HaydenKeers/meower_kicad/_restore_backup_2026-08-23T15-10-23-191/import2.kicad_pcb

## KiCad design _restore_backup_2026-08-23T15-10-23-191/import2.kicad_pcb (2026-08-23)

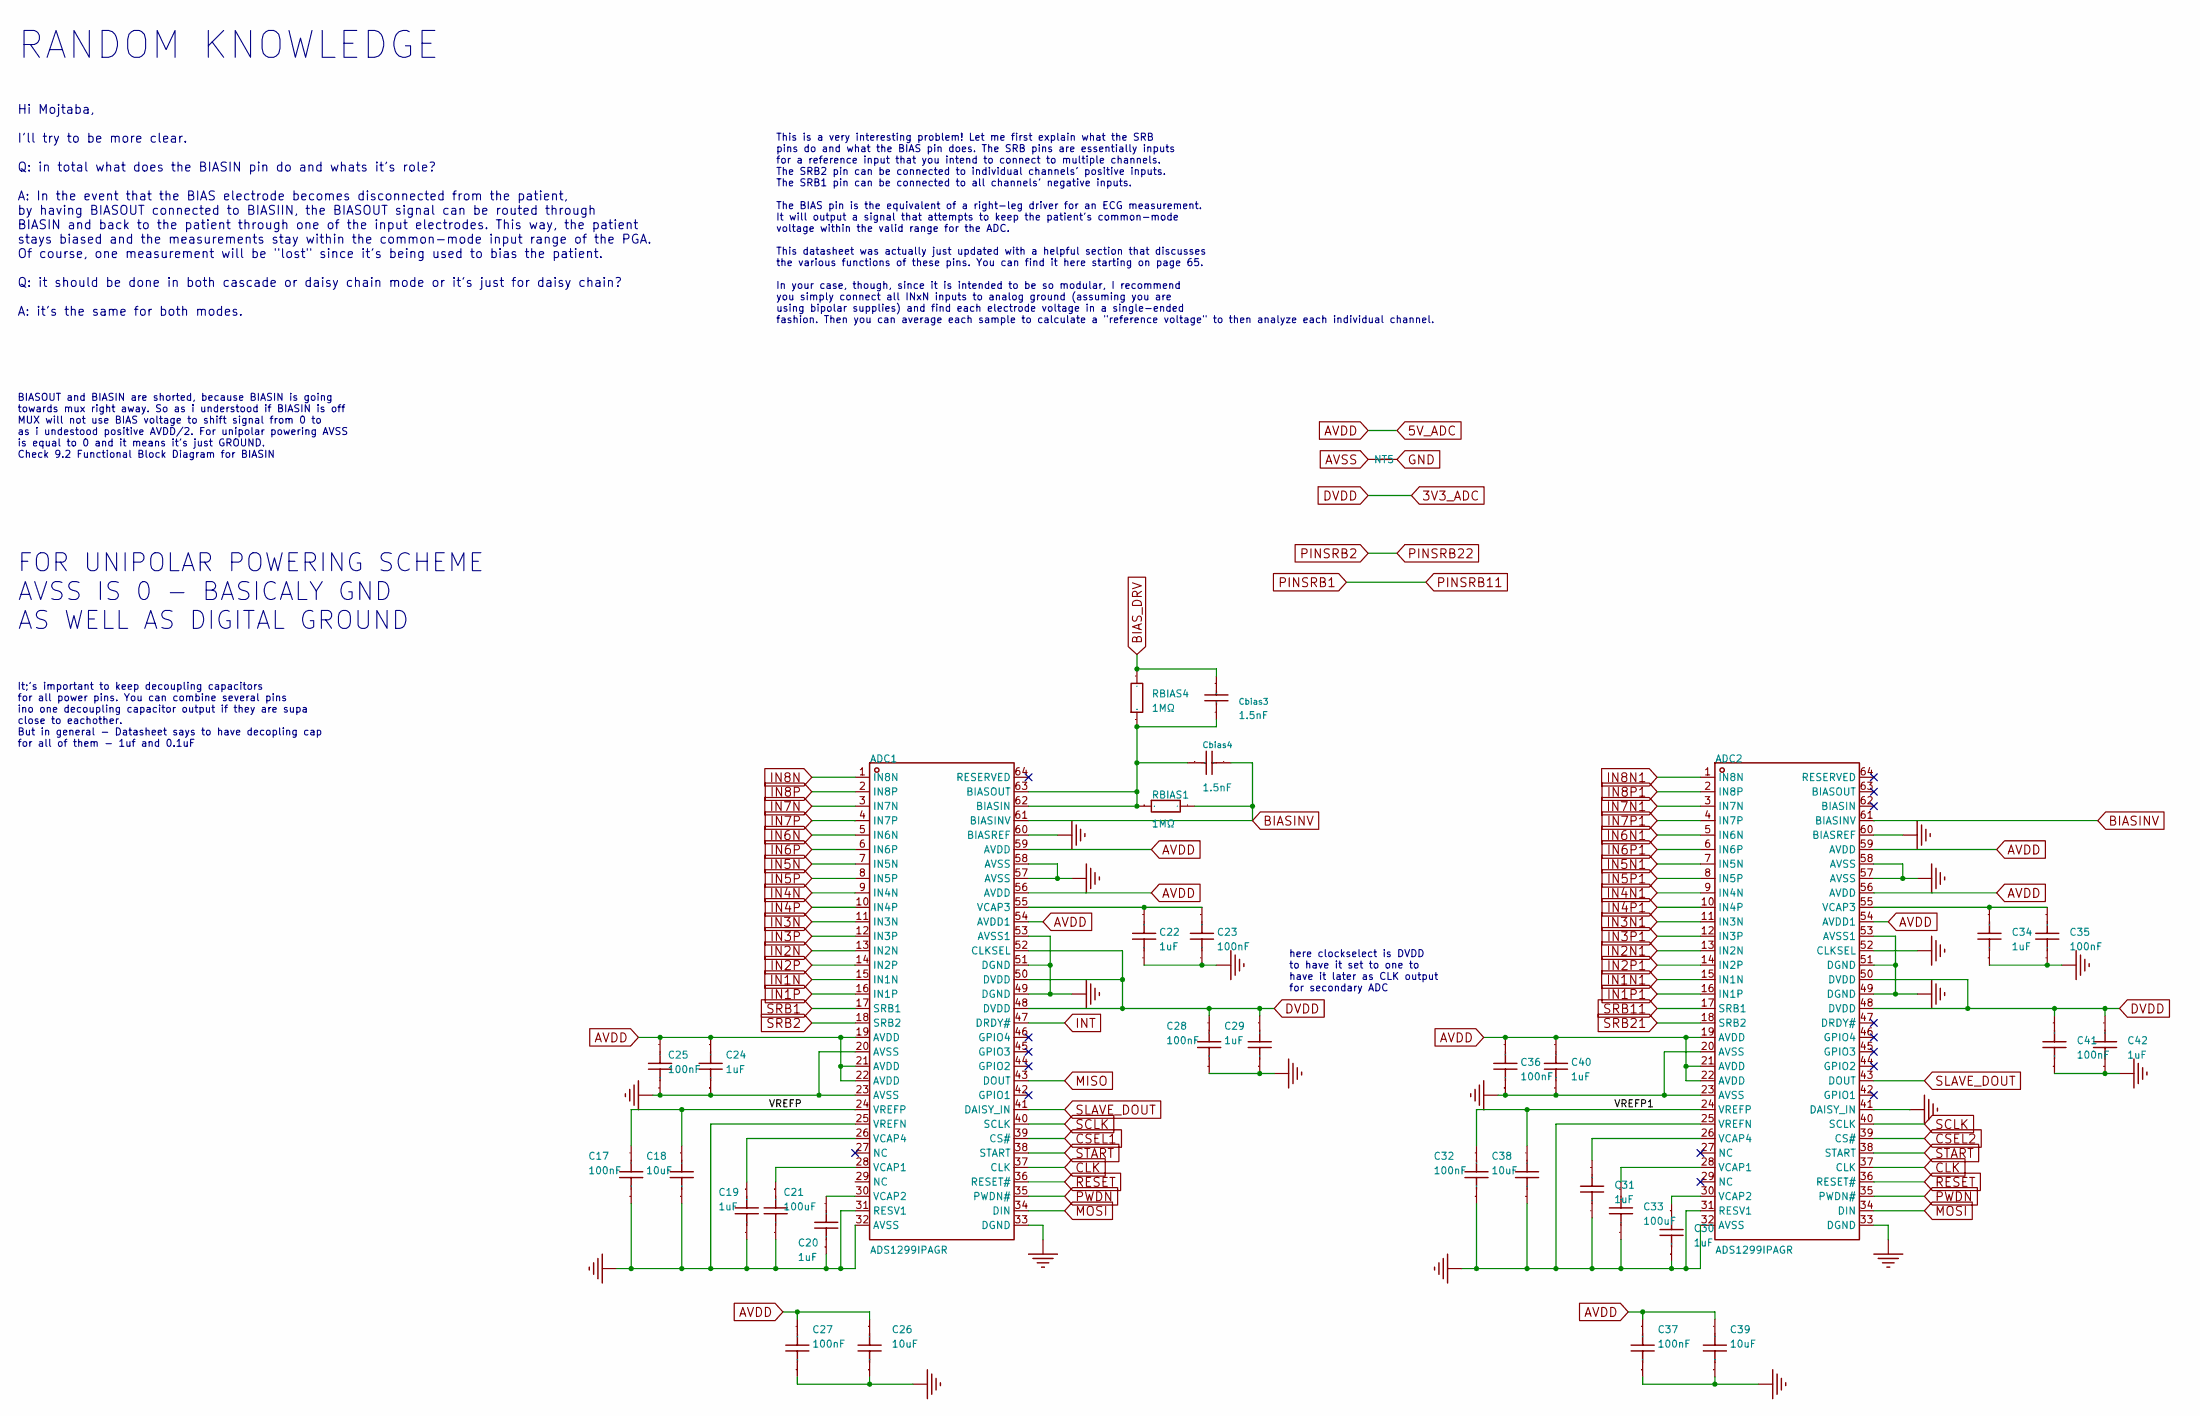
[picture p1: schematic 2_ADCs.kicad_sch]

Parts:
ADC1, ADC2: ADS1299IPAGR; TQFP-64_L10.0-W10.0-P0.50-LS12.0-TL; Voltage - Supply 4.75V~5.25V; Voltage Reference Drift 35ppm/℃; Manufacturer Part ADS1299IPAGR; LCSC Part Name ADS1299-x 低噪声、4/6/8通道、24bit 、同时采样模数转换器，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
C17, C23, C25, C27, C28, C32, C35, C36, C37, C41: 100nF; C0603; Manufacturer Part GRM188R71H104KA93D; LCSC Part Name 100nF ±10% 50V
C18, C26, C38, C39: 10uF; C0805; Manufacturer Part GRM188R61A106KE69D; LCSC Part Name 10uF ±10% 10V
C19, C20, C22, C30, C31, C34: 1uF; C0603; Manufacturer Part GRM188R61E105KA12D; LCSC Part Name 1uF ±10% 25V
C21, C33: 100uF; C1210; Manufacturer Part LMK325BJ107MM-T; LCSC Part Name 100uF ±20% 10V
C24, C29, C40, C42: 1uF; C0805; Manufacturer Part GRM188R61E105KA12D; LCSC Part Name 1uF ±10% 25V
Cbias3, Cbias4: 1.5nF; C0402; Voltage Rating 50V; Manufacturer Part GCM155R71H152KA37D; LCSC Part Name 1.5nF ±10% 50V
NT5: NetTie_2; NetTie-2_SMD_Pad0.5mm
RBIAS1, RBIAS4: 1MΩ; R0603; Manufacturer Part RC0402FR-071ML; LCSC Part Name 厚膜电阻 1MΩ ±1% 62.5mW

Connections:
3V3_ADC: ADC1.48 (DVDD), ADC1.50 (DVDD), ADC1.52 (CLKSEL), ADC2.48 (DVDD), ADC2.50 (DVDD), C28.2, C29.2, C41.2, C42.2; also elsewhere on the board
5V_ADC: ADC1.19 (AVDD), ADC1.21 (AVDD), ADC1.22 (AVDD), ADC1.54 (AVDD1), ADC1.56 (AVDD), ADC1.59 (AVDD), ADC2.19 (AVDD), ADC2.21 (AVDD), ADC2.22 (AVDD), ADC2.54 (AVDD1), ADC2.56 (AVDD), ADC2.59 (AVDD), C24.2, C25.2, C26.2, C27.2, C36.2, C37.2, C39.2, C40.2; also elsewhere on the board
/ADCs/VREFP: ADC1.24 (VREFP), C17.2, C18.2
/ADCs/VREFP1: ADC2.24 (VREFP), C32.2, C38.2
AVSS: ADC1.20 (AVSS), ADC1.23 (AVSS), ADC1.25 (VREFN), ADC1.31 (RESV1), ADC1.32 (AVSS), ADC1.57 (AVSS), ADC1.58 (AVSS), ADC1.60 (BIASREF), ADC2.20 (AVSS), ADC2.23 (AVSS), ADC2.25 (VREFN), ADC2.31 (RESV1), ADC2.32 (AVSS), ADC2.57 (AVSS), ADC2.58 (AVSS), ADC2.60 (BIASREF), C17.1, C18.1, C19.2, C20.1, C21.2, C24.1, C25.1, C30.1, C31.2, C32.1, C33.2, C36.1, C38.1, C40.1, NT5.1; also elsewhere on the board
BIASINV: ADC1.61 (BIASINV), ADC2.61 (BIASINV), Cbias4.2, RBIAS1.2
BIAS_DRV: Cbias3.1, RBIAS4.2; also elsewhere on the board
CLK: ADC1.37 (CLK), ADC2.37 (CLK)
CSEL1: ADC1.39 (CS#); also elsewhere on the board
CSEL2: ADC2.39 (CS#); also elsewhere on the board
GND: ADC1.33 (DGND), ADC1.49 (DGND), ADC1.51 (DGND), ADC1.53 (AVSS1), ADC2.33 (DGND), ADC2.41 (DAISY_IN), ADC2.49 (DGND), ADC2.51 (DGND), ADC2.52 (CLKSEL), ADC2.53 (AVSS1), C22.2, C23.2, C26.1, C27.1, C28.1, C29.1, C34.2, C35.2, C37.1, C39.1, C41.1, C42.1, NT5.2; also elsewhere on the board
IN1N: ADC1.15 (IN1N); also elsewhere on the board
IN1N1: ADC2.15 (IN1N); also elsewhere on the board
IN1P: ADC1.16 (IN1P); also elsewhere on the board
IN1P1: ADC2.16 (IN1P); also elsewhere on the board
IN2N: ADC1.13 (IN2N); also elsewhere on the board
IN2N1: ADC2.13 (IN2N); also elsewhere on the board
IN2P: ADC1.14 (IN2P); also elsewhere on the board
IN2P1: ADC2.14 (IN2P); also elsewhere on the board
IN3N: ADC1.11 (IN3N); also elsewhere on the board
IN3N1: ADC2.11 (IN3N); also elsewhere on the board
IN3P: ADC1.12 (IN3P); also elsewhere on the board
IN3P1: ADC2.12 (IN3P); also elsewhere on the board
IN4N: ADC1.9 (IN4N); also elsewhere on the board
IN4N1: ADC2.9 (IN4N); also elsewhere on the board
IN4P: ADC1.10 (IN4P); also elsewhere on the board
IN4P1: ADC2.10 (IN4P); also elsewhere on the board
IN5N: ADC1.7 (IN5N); also elsewhere on the board
IN5N1: ADC2.7 (IN5N); also elsewhere on the board
IN5P: ADC1.8 (IN5P); also elsewhere on the board
IN5P1: ADC2.8 (IN5P); also elsewhere on the board
IN6N: ADC1.5 (IN6N); also elsewhere on the board
IN6N1: ADC2.5 (IN6N); also elsewhere on the board
IN6P: ADC1.6 (IN6P); also elsewhere on the board
IN6P1: ADC2.6 (IN6P); also elsewhere on the board
IN7N: ADC1.3 (IN7N); also elsewhere on the board
IN7N1: ADC2.3 (IN7N); also elsewhere on the board
IN7P: ADC1.4 (IN7P); also elsewhere on the board
IN7P1: ADC2.4 (IN7P); also elsewhere on the board
IN8N: ADC1.1 (IN8N); also elsewhere on the board
IN8N1: ADC2.1 (IN8N); also elsewhere on the board
IN8P: ADC1.2 (IN8P); also elsewhere on the board
IN8P1: ADC2.2 (IN8P); also elsewhere on the board
INT: ADC1.47 (DRDY#); also elsewhere on the board
MISO: ADC1.43 (DOUT); also elsewhere on the board
MOSI: ADC1.34 (DIN), ADC2.34 (DIN); also elsewhere on the board
unnamed: ADC1.62 (BIASIN), ADC1.63 (BIASOUT), Cbias3.2, Cbias4.1, RBIAS1.1, RBIAS4.1
unnamed: ADC1.28 (VCAP1), C21.1
unnamed: ADC1.30 (VCAP2), C20.2
unnamed: ADC1.55 (VCAP3), C22.1, C23.1
unnamed: ADC1.26 (VCAP4), C19.1
unnamed: ADC2.28 (VCAP1), C33.1
unnamed: ADC2.30 (VCAP2), C30.2
unnamed: ADC2.55 (VCAP3), C34.1, C35.1
unnamed: ADC2.26 (VCAP4), C31.1
PWDN: ADC1.35 (PWDN#), ADC2.35 (PWDN#); also elsewhere on the board
RESET: ADC1.36 (RESET#), ADC2.36 (RESET#); also elsewhere on the board
SCLK: ADC1.40 (SCLK), ADC2.40 (SCLK); also elsewhere on the board
SLAVE_DOUT: ADC1.41 (DAISY_IN), ADC2.43 (DOUT)
SRB1: ADC1.17 (SRB1); also elsewhere on the board
SRB2: ADC1.18 (SRB2); also elsewhere on the board
SRB11: ADC2.17 (SRB1); also elsewhere on the board
SRB21: ADC2.18 (SRB2); also elsewhere on the board
START: ADC1.38 (START), ADC2.38 (START); also elsewhere on the board

Notes on the sheet:
It;'s important to keep decoupling capacitors for all power pins. You can combine several pins ino one decoupling capacitor output if they are supa close to eachother. But in general - Datasheet says to have decopling cap for all of them - 1uf and 0.1uF
FOR UNIPOLAR POWERING SCHEME AVSS IS 0 - BASICALY GND AS WELL AS DIGITAL GROUND
Hi Mojtaba, I'll try to be more clear. Q: in total what does the BIASIN pin do and whats it's role? A: In the event that the BIAS electrode becomes disconnected from the patient, by having BIASOUT connected to BIASIIN, the BIASOUT signal can be routed through BIASIN and back to the patient through 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
BIASOUT and BIASIN are shorted, because BIASIN is going towards mux right away. So as i understood if BIASIN is off MUX will not use BIAS voltage to shift signal from 0 to as i undestood positive AVDD/2. For unipolar powering AVSS is equal to 0 and it means it's just GROUND. Check 9.2 Functional Bl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
here clockselect is DVDD to have it set to one to have it later as CLK output for secondary ADC
This is a very interesting problem! Let me first explain what the SRB pins do and what the BIAS pin does. The SRB pins are essentially inputs for a reference input that you intend to connect to multiple channels. The SRB2 pin can be connected to individual channels' positive inputs. The SRB1 pin ca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
RANDOM KNOWLEDGE

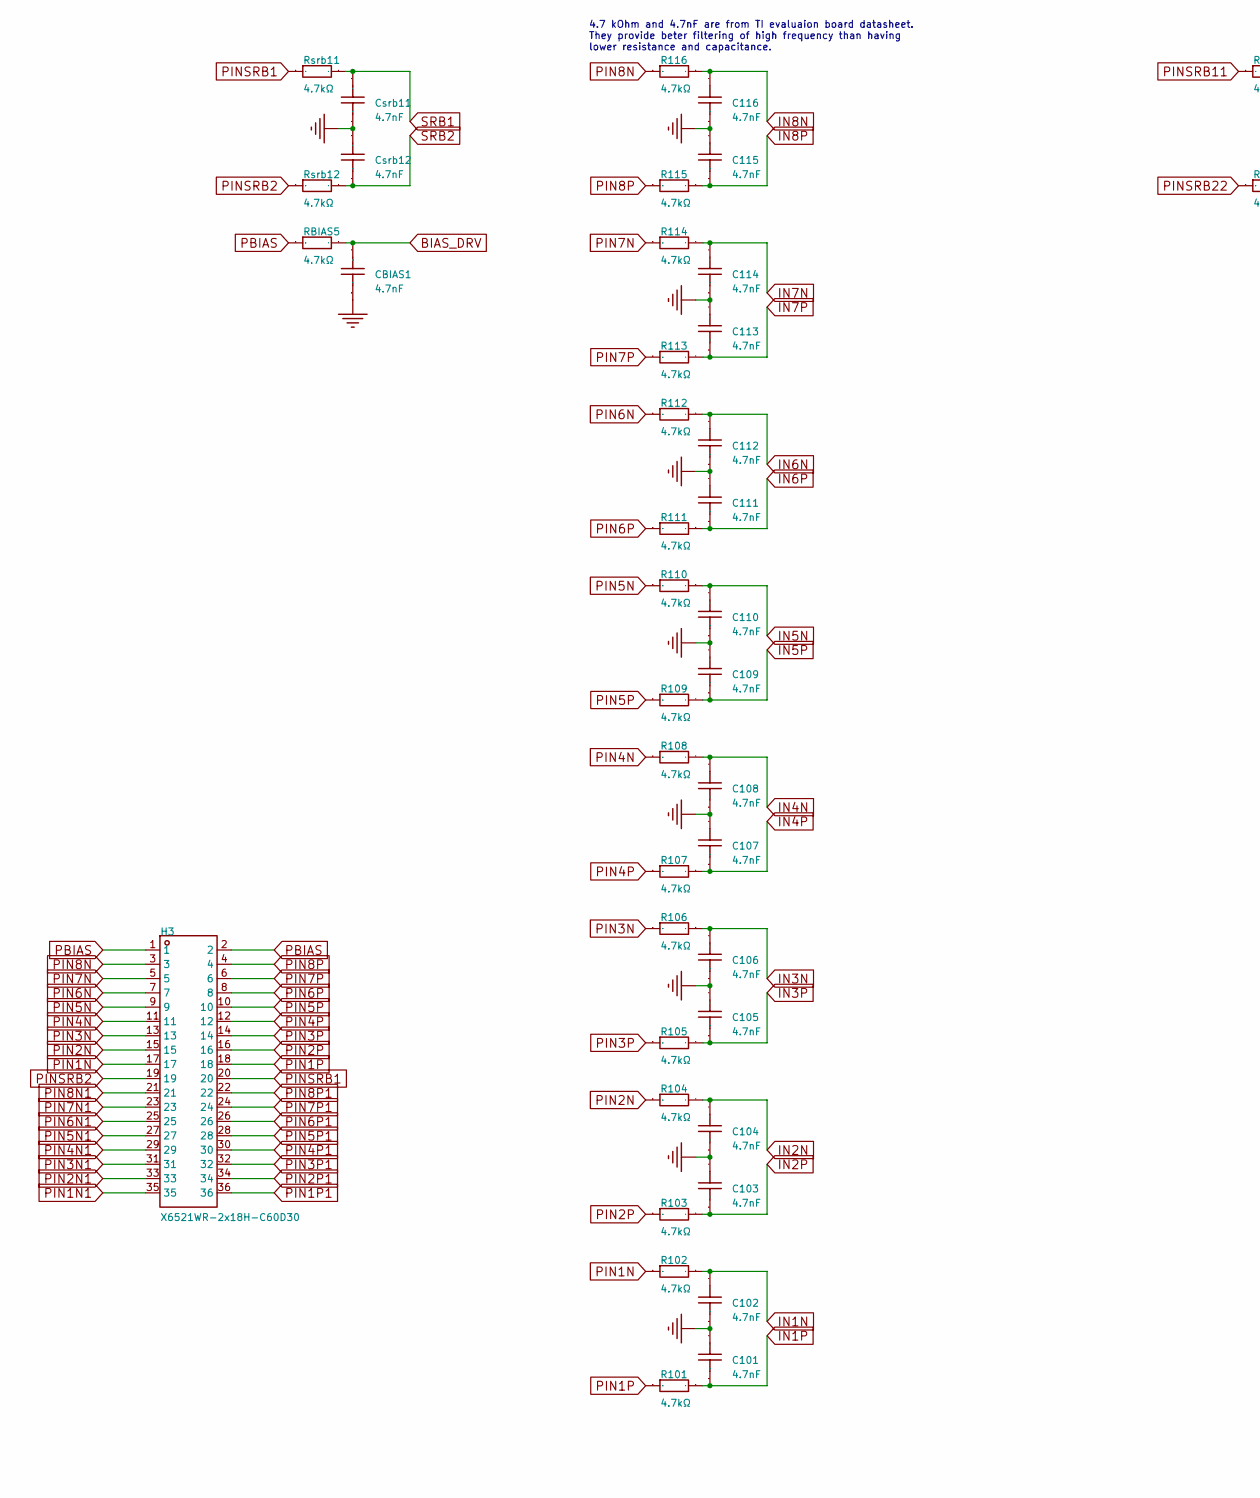
[picture p2: schematic 3_ADC pins and connector.kicad_sch, part in row 1, column 1]

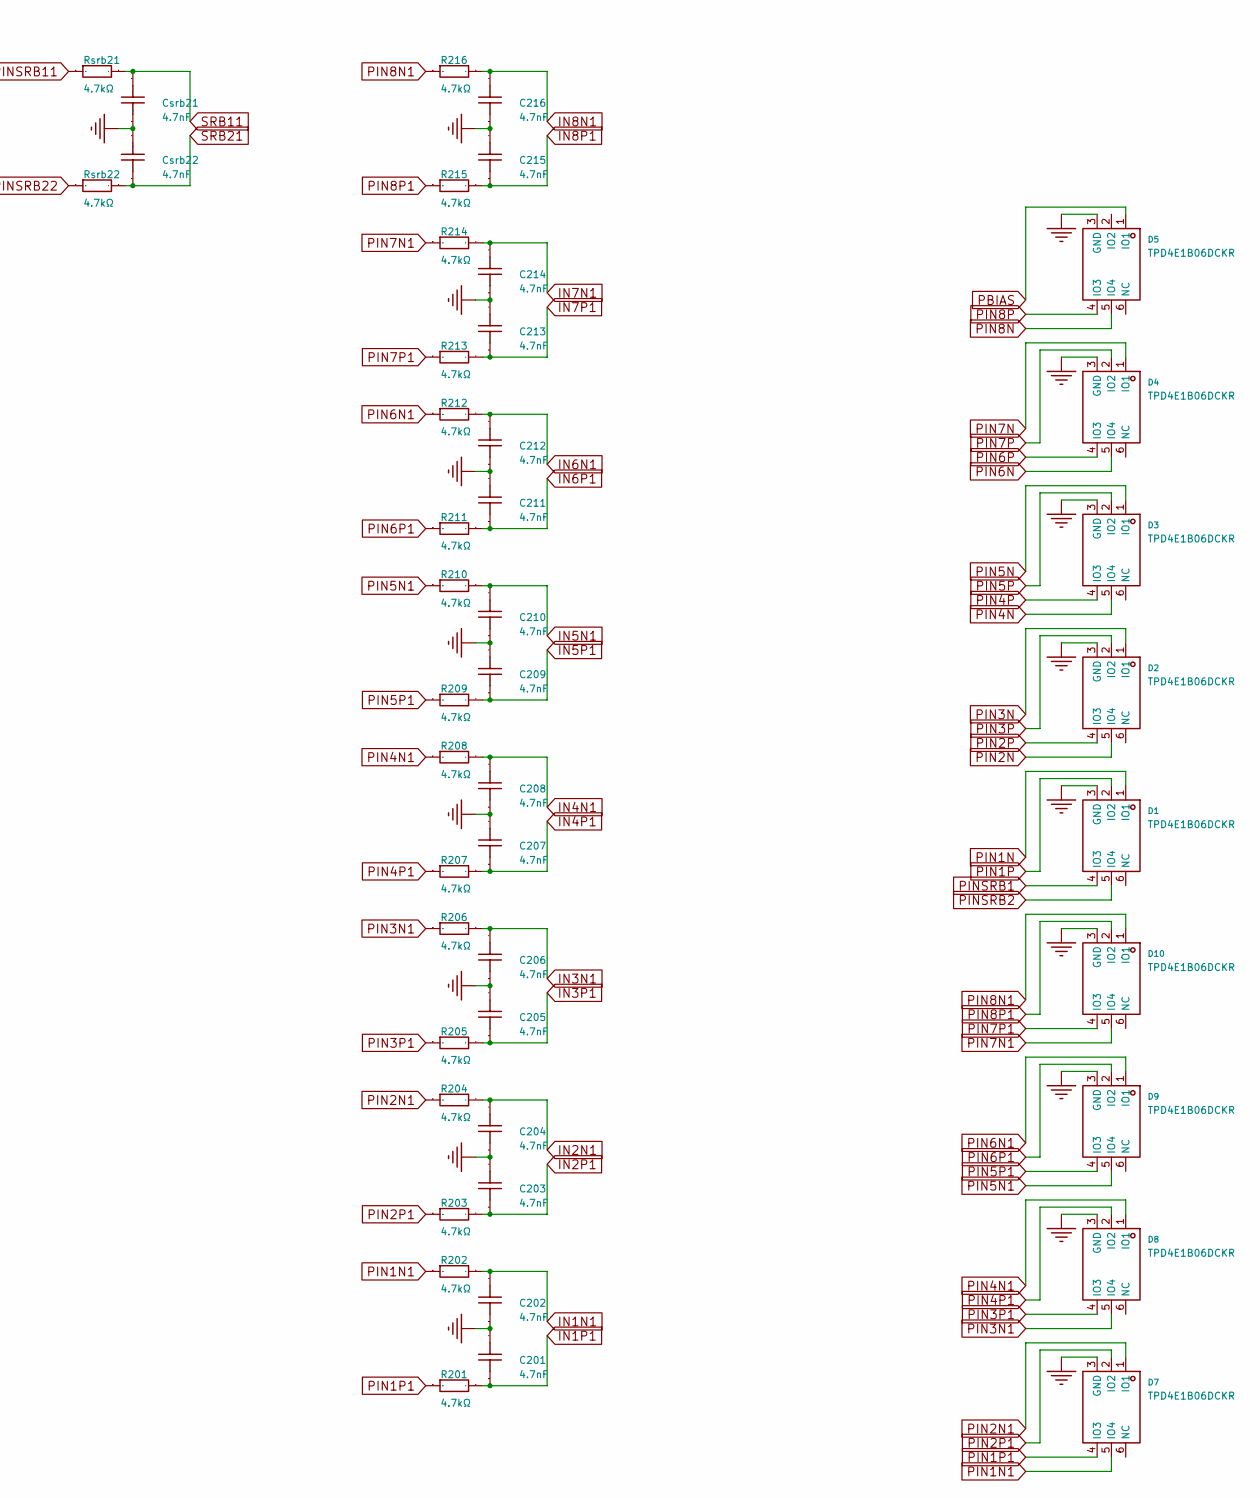
[picture p3: schematic 3_ADC pins and connector.kicad_sch, part in row 1, column 2]

Parts:
C101, C102, C103, C104, C105, C106, C107, C108, C109, C110, C111, C112, C113, C114, C115, C116, C201, C202, C203, C204, C205, C206, C207, C208, C209, C210, C211, C212, C213, C214, C215, C216: 4.7nF; C0402; Tolerance ±2%; Voltage Rating 50V; Manufacturer Part GRM1555C1H472GE01D; LCSC Part Name 4.7nF ±2% 50V
CBIAS1: 4.7nF; C0402; Tolerance ±2%; Voltage Rating 50V; Manufacturer Part GRM1555C1H472GE01D; LCSC Part Name 4.7nF ±2% 50V
Csrb11, Csrb12, Csrb21, Csrb22: 4.7nF; C0402; Tolerance ±2%; Voltage Rating 50V; Manufacturer Part GRM1555C1H472GE01D; LCSC Part Name 4.7nF ±2% 50V
D1, D2, D3, D4, D5, D7, D8, D9, D10: TPD4E1B06DCKR; SC-70-6_L2.2-W1.3-P0.65-LS2.1-BL; Manufacturer Part TPD4E1B06DCKR; LCSC Part Name TPD4E1B06DCKR
H3: X6521WR-2x18H-C60D30; HDR-TH_36P-P2.54-H-M-R2-C18-S2.54; Manufacturer Part X6521WR-2x18H-C60D30; LCSC Part Name 2x18P 间距:2.54mm 方针
R101, R102, R103, R104, R105, R106, R107, R108, R109, R110, R111, R112, R113, R114, R115, R116, R201, R202, R203, R204, R205, R206, R207, R208, R209, R210, R211, R212, R213, R214, R215, R216: 4.7kΩ; R0402; Manufacturer Part RC0402FR-074K7L; LCSC Part Name 厚膜电阻 4.7kΩ ±1% 62.5mW
RBIAS5: 4.7kΩ; R0402; Manufacturer Part RC0402FR-074K7L; LCSC Part Name 厚膜电阻 4.7kΩ ±1% 62.5mW
Rsrb11, Rsrb12, Rsrb21, Rsrb22: 4.7kΩ; R0402; Manufacturer Part RC0402FR-074K7L; LCSC Part Name 厚膜电阻 4.7kΩ ±1% 62.5mW

Connections:
AVSS: C101.2, C102.1, C103.2, C104.1, C105.2, C106.1, C107.2, C108.1, C109.2, C110.1, C111.2, C112.1, C113.2, C114.1, C115.2, C116.1, C201.2, C202.1, C203.2, C204.1, C205.2, C206.1, C207.2, C208.1, C209.2, C210.1, C211.2, C212.1, C213.2, C214.1, C215.2, C216.1, CBIAS1.1, Csrb11.1, Csrb12.2, Csrb21.1, Csrb22.2, D1.3 (GND), D2.3 (GND), D3.3 (GND), D4.3 (GND), D5.3 (GND), D7.3 (GND), D8.3 (GND), D9.3 (GND), D10.3 (GND); also elsewhere on the board
BIAS_DRV: CBIAS1.2, RBIAS5.2; also elsewhere on the board
IN1N: C102.2, R102.2; also elsewhere on the board
IN1N1: C202.2, R202.2; also elsewhere on the board
IN1P: C101.1, R101.2; also elsewhere on the board
IN1P1: C201.1, R201.2; also elsewhere on the board
IN2N: C104.2, R104.2; also elsewhere on the board
IN2N1: C204.2, R204.2; also elsewhere on the board
IN2P: C103.1, R103.2; also elsewhere on the board
IN2P1: C203.1, R203.2; also elsewhere on the board
IN3N: C106.2, R106.2; also elsewhere on the board
IN3N1: C206.2, R206.2; also elsewhere on the board
IN3P: C105.1, R105.2; also elsewhere on the board
IN3P1: C205.1, R205.2; also elsewhere on the board
IN4N: C108.2, R108.2; also elsewhere on the board
IN4N1: C208.2, R208.2; also elsewhere on the board
IN4P: C107.1, R107.2; also elsewhere on the board
IN4P1: C207.1, R207.2; also elsewhere on the board
IN5N: C110.2, R110.2; also elsewhere on the board
IN5N1: C210.2, R210.2; also elsewhere on the board
IN5P: C109.1, R109.2; also elsewhere on the board
IN5P1: C209.1, R209.2; also elsewhere on the board
IN6N: C112.2, R112.2; also elsewhere on the board
IN6N1: C212.2, R212.2; also elsewhere on the board
IN6P: C111.1, R111.2; also elsewhere on the board
IN6P1: C211.1, R211.2; also elsewhere on the board
IN7N: C114.2, R114.2; also elsewhere on the board
IN7N1: C214.2, R214.2; also elsewhere on the board
IN7P: C113.1, R113.2; also elsewhere on the board
IN7P1: C213.1, R213.2; also elsewhere on the board
IN8N: C116.2, R116.2; also elsewhere on the board
IN8N1: C216.2, R216.2; also elsewhere on the board
IN8P: C115.1, R115.2; also elsewhere on the board
IN8P1: C215.1, R215.2; also elsewhere on the board
PBIAS: D5.1 (IO1), H3.1, H3.2, RBIAS5.1
PIN1N: D1.1 (IO1), H3.17, R102.1
PIN1N1: D7.5 (IO4), H3.35, R202.1
PIN1P: D1.2 (IO2), H3.18, R101.1
PIN1P1: D7.4 (IO3), H3.36, R201.1
PIN2N: D2.5 (IO4), H3.15, R104.1
PIN2N1: D7.1 (IO1), H3.33, R204.1
PIN2P: D2.4 (IO3), H3.16, R103.1
PIN2P1: D7.2 (IO2), H3.34, R203.1
PIN3N: D2.1 (IO1), H3.13, R106.1
PIN3N1: D8.5 (IO4), H3.31, R206.1
PIN3P: D2.2 (IO2), H3.14, R105.1
PIN3P1: D8.4 (IO3), H3.32, R205.1
PIN4N: D3.5 (IO4), H3.11, R108.1
PIN4N1: D8.1 (IO1), H3.29, R208.1
PIN4P: D3.4 (IO3), H3.12, R107.1
PIN4P1: D8.2 (IO2), H3.30, R207.1
PIN5N: D3.1 (IO1), H3.9, R110.1
PIN5N1: D9.5 (IO4), H3.27, R210.1
PIN5P: D3.2 (IO2), H3.10, R109.1
PIN5P1: D9.4 (IO3), H3.28, R209.1
PIN6N: D4.5 (IO4), H3.7, R112.1
PIN6N1: D9.1 (IO1), H3.25, R212.1
PIN6P: D4.4 (IO3), H3.8, R111.1
PIN6P1: D9.2 (IO2), H3.26, R211.1
PIN7N: D4.1 (IO1), H3.5, R114.1
PIN7N1: D10.5 (IO4), H3.23, R214.1
PIN7P: D4.2 (IO2), H3.6, R113.1
PIN7P1: D10.4 (IO3), H3.24, R213.1
PIN8N: D5.5 (IO4), H3.3, R116.1
PIN8N1: D10.1 (IO1), H3.21, R216.1
PIN8P: D5.4 (IO3), H3.4, R115.1
PIN8P1: D10.2 (IO2), H3.22, R215.1
SRB1: Csrb11.2, Rsrb11.2; also elsewhere on the board
SRB2: Csrb12.1, Rsrb12.2; also elsewhere on the board
SRB11: Csrb21.2, Rsrb21.2; also elsewhere on the board
SRB21: Csrb22.1, Rsrb22.2; also elsewhere on the board

Notes on the sheet:
4.7 kOhm and 4.7nF are from TI evaluaion board datasheet. They provide beter filtering of high frequency than having lower resistance and capacitance.

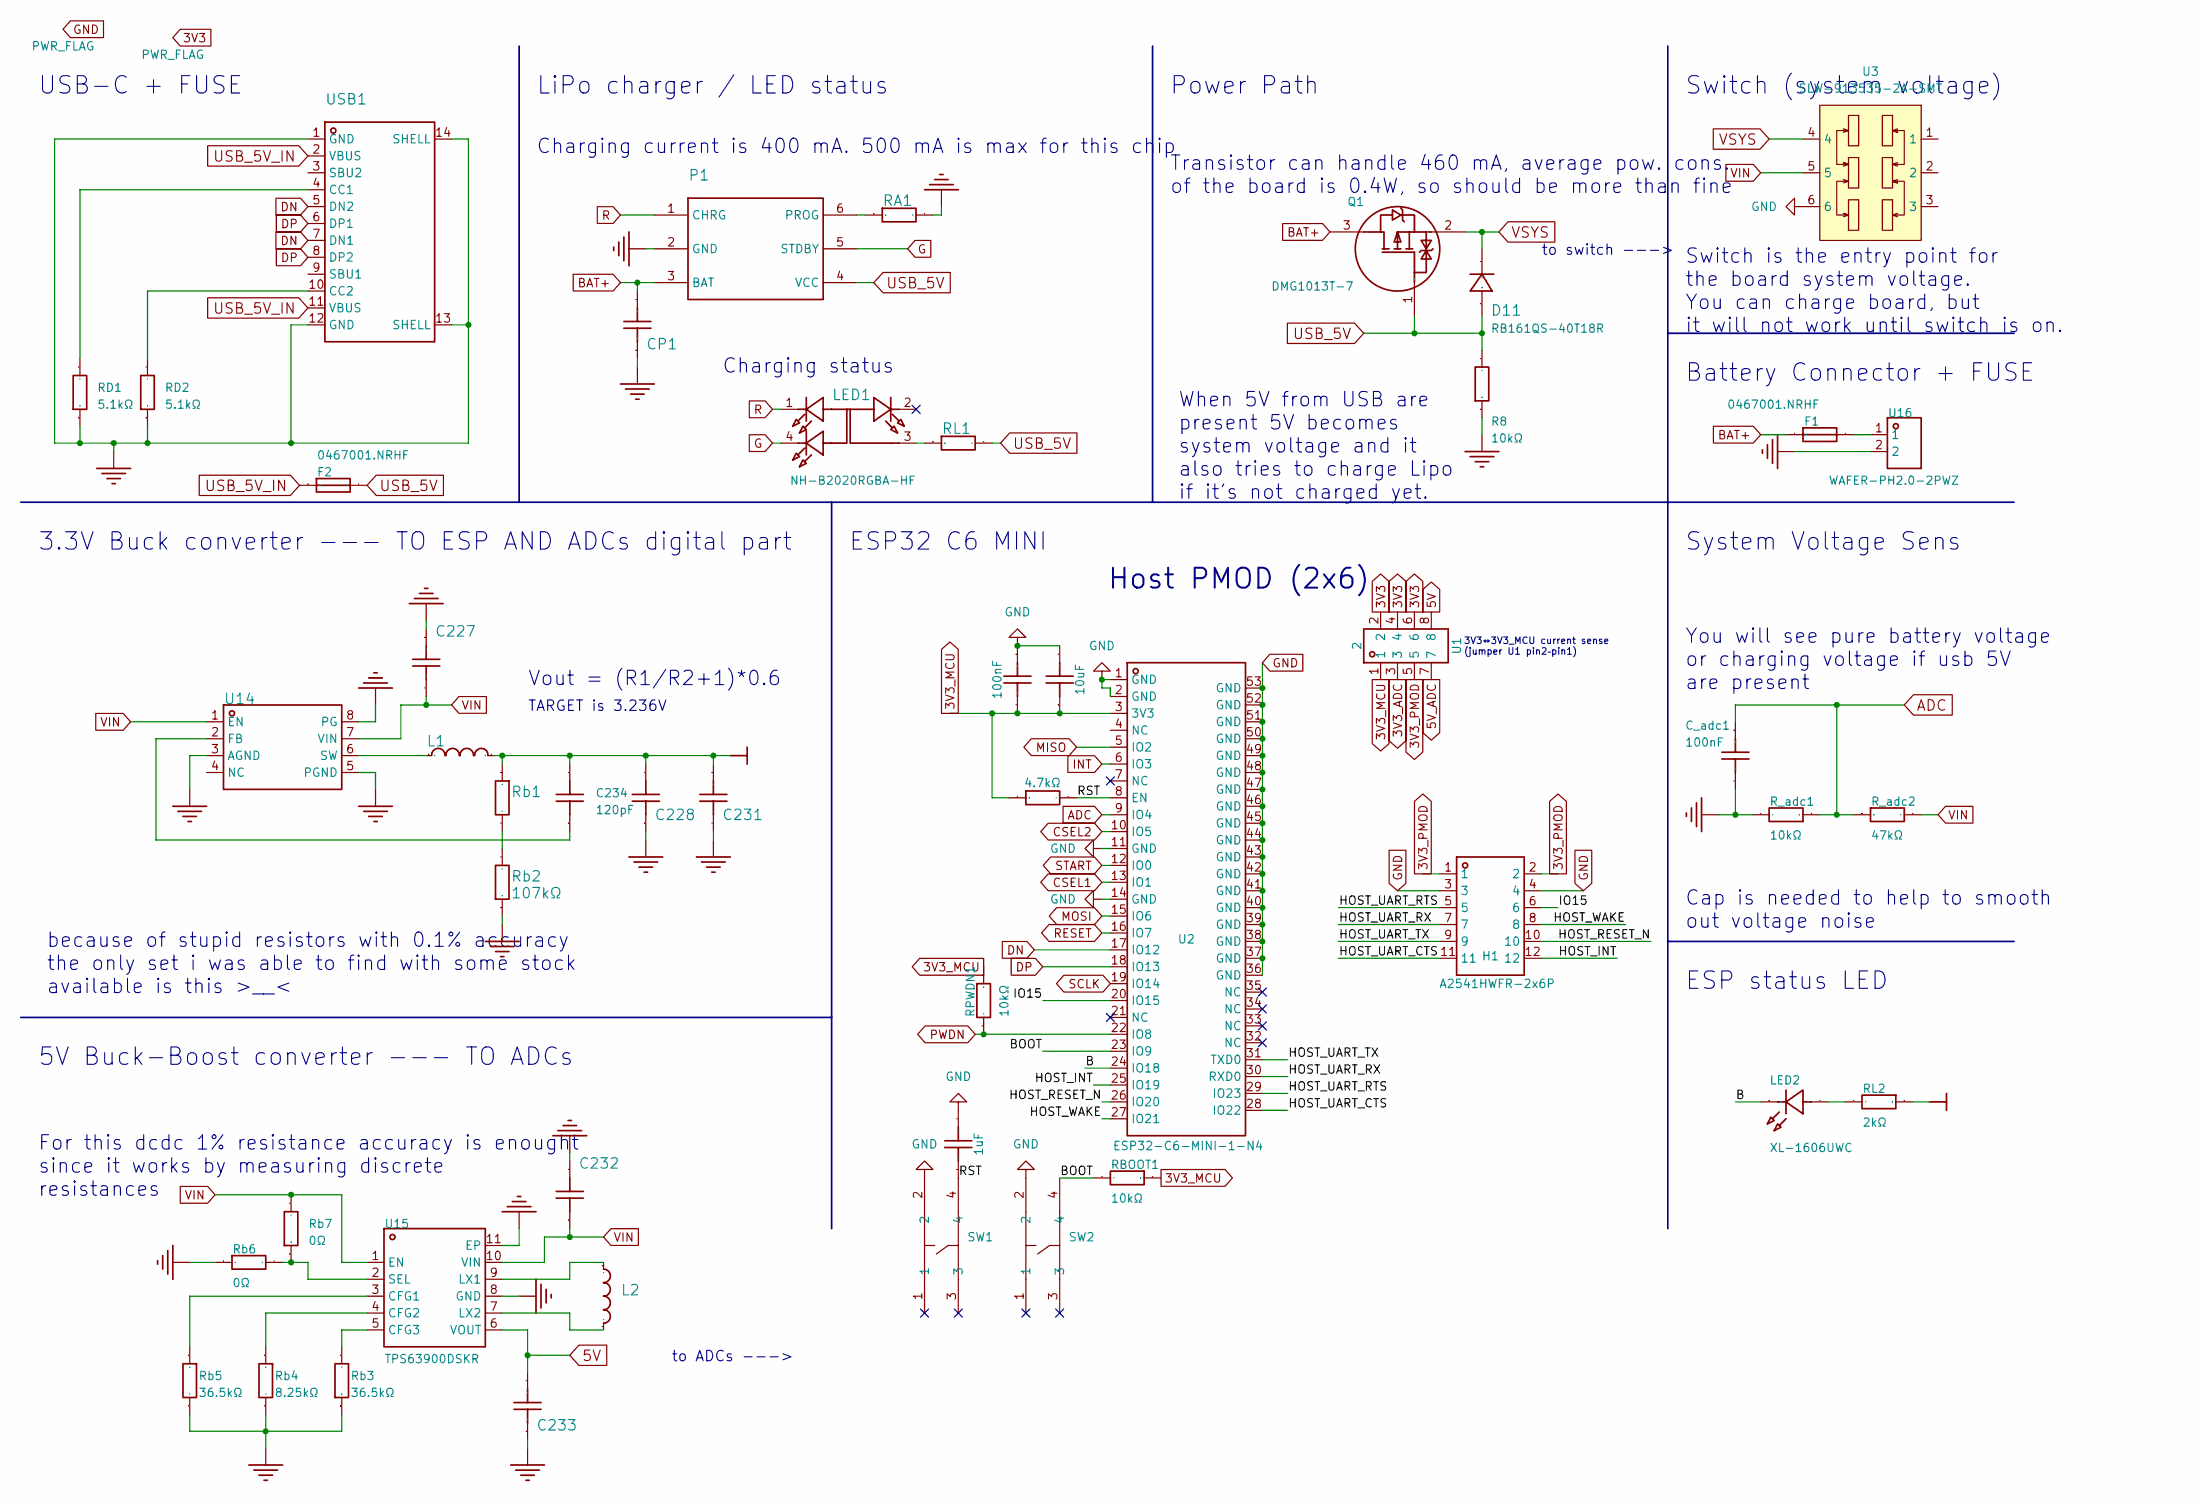
[picture p4: schematic 7_ESP and Power.kicad_sch]

Parts:
C222: 10uF; C0805; Manufacturer Part CL10A106KP8NNNC
C223: 100nF; C0603; Manufacturer Part GRM188R71H104KA93D
C224: 1uF; C0603; Manufacturer Part CL10A105KA8NNNC
C227: 4.7uF; C0603; Manufacturer Part GRM188Z71C475KE21D; LCSC Part Name 4.7uF ±10% 16V
C228, C231, C232: 10uF; C0603; Manufacturer Part GRM188Z71A106MA73D; LCSC Part Name 10uF ±20% 10V
C233: 22uF; C0603; Manufacturer Part GRM187R60J226ME15D; LCSC Part Name 22uF ±20% 6.3V
C234: 120pF; C0402; Tolerance ±1%; Voltage Rating 50V; Manufacturer Part AC0402FRNPO9BN121; LCSC Part Name 120pF ±1% 50V
CP1: 10uF; C0603; Manufacturer Part CL10A106KP8NNNC; LCSC Part Name 10uF ±10% 10V
C_adc1: 100nF; C0402; Voltage Rating 16V; Manufacturer Part CT41G-0402-2X1-16V-0.1uF-K(N); LCSC Part Name 100nF ±10% 16V
D11: RB161QS-40T18R; X2-DFN1006-2_L1.0-W0.6-P0.65-RD; Manufacturer Part RB161QS-40T18R; LCSC Part Name 电压:40V 电流:1A
F1, F2: 0467001.NRHF; F0603; Manufacturer Part 0467001.NRHF; LCSC Part Name 32V贴片式保险丝
H1: A2541HWFR-2x6P; HDR-TH_12P-P2.54-H-F-R2-C6-S2.54-W10.2; Manufacturer Part HC-PM254-8.5H-2x6PW
L1: 470nH; L1008; Manufacturer Part DFE201610E-R47M=P2; LCSC Part Name 470nH ±20% 4.8A
L2: 2.2uH; L1008; Manufacturer Part DFE252012F-2R2M=P2; LCSC Part Name 2.2uH ±20% 3.6A
LED1: NH-B2020RGBA-HF; LED-ARRAY-SMD_4P-L2.1-W2.1-TL_NH-B2020RGBA; Manufacturer Part NH-B2020RGBA-HF; LCSC Part Name NH-B2020RGBA-HF
LED2: XL-1606UWC; LED-SMD_L1.7-W0.6-RD; Manufacturer Part XL-1606UWC; LCSC Part Name XL-1606UWC
P1: SOT-23-6_L2.9-W1.6-P0.95-LS2.8-BL; Manufacturer Part TP4057-42-SOT26-R; LCSC Part Name TP4057 1%
Q1: DMG1013T-7; SC-75-3_L1.6-W0.8-P1.00-LS1.6-BR; Manufacturer Part DMG1013T-7; LCSC Part Name 1个P沟道 耐压:20V 电流:460mA
R1: 4.7kΩ; R0402; Manufacturer Part RC0402FR-074K7L
R8: 10kΩ; R0402; Overload Voltage (Max) 50V; Manufacturer Part 0402WGF1002TCE; LCSC Part Name 10kΩ ±1% 62.5mW 厚膜电阻
RA1: 2kΩ; R0402; Overload Voltage (Max) 50V; Manufacturer Part 0402WGF2001TCE; LCSC Part Name 2kΩ ±1% 62.5mW 厚膜电阻
RBOOT1: 10kΩ; R0402; Overload Voltage (Max) 50V; Manufacturer Part 0402WGJ0103TCE; LCSC Part Name 10kΩ ±1% 62.5mW 厚膜电阻
RD1, RD2: 5.1kΩ; R0402; Overload Voltage (Max) 50V; Manufacturer Part 0402WGF5101TCE; LCSC Part Name 5.1kΩ ±1% 62.5mW 厚膜电阻
RL1, RL2: 2kΩ; R0402; Overload Voltage (Max) 50V; Manufacturer Part 0402WGF2001TCE; LCSC Part Name 2kΩ ±1% 62.5mW 厚膜电阻
RPWDN1: 10kΩ; R0402; Overload Voltage (Max) 50V; Manufacturer Part 0402WGJ0103TCE; LCSC Part Name 10kΩ ±1% 62.5mW 厚膜电阻
R_adc1: 10kΩ; R0402; Overload Voltage (Max) 50V; Manufacturer Part 0402WGF1002TCE; LCSC Part Name 10kΩ ±1% 62.5mW 厚膜电阻
R_adc2: 47kΩ; R0402; Overload Voltage (Max) 50V; Manufacturer Part 0402WGF4702TCE; LCSC Part Name 47kΩ ±1% 62.5mW 厚膜电阻
Rb1: 470kΩ; R0402; Manufacturer Part AR02BTC4703; LCSC Part Name 薄膜电阻 470kΩ ±0.1% 62.5mW
Rb2: 107kΩ; R0402; Tolerance ±1%; Voltage-Supply(Max) 50V; Manufacturer Part RMC0402107K1%N; LCSC Part Name 107kΩ ±1% 62.5mW
Rb3, Rb5: 36.5kΩ; R0402; Manufacturer Part RC0402FR-0736K5L; LCSC Part Name 厚膜电阻 36.5kΩ ±1% 62.5mW
Rb4: 8.25kΩ; R0402; Manufacturer Part RC0402FR-078K25L; LCSC Part Name 厚膜电阻 8.25kΩ ±1% 62.5mW
Rb6: 0Ω; R0402; Manufacturer Part 0402WGF0000TCE; LCSC Part Name 0Ω ±1% 62.5mW 厚膜电阻
Rb7: 0Ω; R0402; Manufacturer Part RC0402FR-070RL; LCSC Part Name 厚膜电阻 0Ω ±1% 62.5mW
SW1, SW2: PTS810SJM250SMTRLFS; KEY-SMD_4P-L4.2-W3.2-P2.20-LS4.6; MPN PTS810SJM250SMTRLFS; LCSC Part C116501
U1: 2; HDR-TH_8P-P2.54-V-M-R2-C4-S2.54; Manufacturer Part 2541WV-2x04P
U2: ESP32-C6-MINI-1-N4; WIFIM-SMD_61P-L16.6-W13.2-P0.80-ESP32-C6-MINI-1-N4; Manufacturer Part ESP32-C6-MINI-1-N4
U3: SLW-913535-2A-SMT; SW-SMD_SLW-913535-2A-SMT; MPN SLW-913535-2A-SMT; LCSC Part C19626182
U14: VSON-8_L2.0-W1.5-P0.50-BL; Manufacturer Part TPS62821DLCR; LCSC Part Name TPS62821DLCR
U15: TPS63900DSKR; WSON-10_L2.5-W2.5-W0.50-TL-EP; Manufacturer Part TPS63900DSKR; LCSC Part Name 1.8V至5.5V,75nA超低静态电流同步升降压转换器
U16: WAFER-PH2.0-2PWZ; CONN-TH_2P-P2.00_GP01-2001WR-2P; Manufacturer Part WAFER-PH2.0-2PWZ; LCSC Part Name 1x2P 间距:2mm 弯插 系列:PH
USB1: USB-C-SMD_TYPE-C-6PIN-2MD-073; Manufacturer Part TYPE-C 16PIN 2MD(073); LCSC Part Name Type-C 母 卧贴

Connections:
3V3: C228.2, C231.1, C234.2, L1.2, RL2.1, Rb1.1, U1.2, U1.4, U1.6
3V3_ADC: U1.3; also elsewhere on the board
3V3_MCU: C222.1, C223.2, R1.1, RBOOT1.1, RPWDN1.1, U1.1, U2.3 (3V3)
3V3_PMOD: H1.1, H1.2, U1.5
5V: C233.2, U1.8, U15.6 (VOUT)
5V_ADC: U1.7; also elsewhere on the board
/ESP and Power/B: LED2.1 (K), U2.24 (IO18)
/ESP and Power/BOOT: RBOOT1.2, SW2.4, U2.23 (IO9)
/ESP and Power/HOST_INT: H1.12, U2.25 (IO19)
/ESP and Power/HOST_RESET_N: H1.10, U2.26 (IO20)
/ESP and Power/HOST_UART_CTS: H1.11, U2.28 (IO22)
/ESP and Power/HOST_UART_RTS: H1.5, U2.29 (IO23)
/ESP and Power/HOST_UART_RX: H1.7, U2.30 (RXD0)
/ESP and Power/HOST_UART_TX: H1.9, U2.31 (TXD0)
/ESP and Power/HOST_WAKE: H1.8, U2.27 (IO21)
/ESP and Power/IO15: H1.6, U2.20 (IO15)
/ESP and Power/RST: C224.1, R1.2, SW1.4, U2.8 (EN)
ADC: C_adc1.1, R_adc1.1, R_adc2.1, U2.9 (IO4)
BAT+: CP1.2, F1.1, P1.3 (BAT), Q1.3 (D)
CSEL1: U2.13 (IO1); also elsewhere on the board
CSEL2: U2.10 (IO5); also elsewhere on the board
DN: U2.17 (IO12), USB1.5 (DN2), USB1.7 (DN1)
DP: U2.18 (IO13), USB1.6 (DP1), USB1.8 (DP2)
G: LED1.4 (-), P1.5 (STDBY)
GND: C222.2, C223.1, C224.2, C227.1, C228.1, C231.2, C232.2, C233.1, CP1.1, C_adc1.2, H1.3, H1.4, P1.2 (GND), R8.1, RA1.2, RD1.1, RD2.1, R_adc1.2, Rb2.1, Rb3.1, Rb4.2, Rb5.2, Rb6.1, SW1.2, SW2.2, U2.1 (GND), U2.2 (GND), U2.11 (GND), U2.14 (GND), U2.36 (GND), U2.37 (GND), U2.38 (GND), U2.39 (GND), U2.40 (GND), U2.41 (GND), U2.42 (GND), U2.43 (GND), U2.44 (GND), U2.45 (GND), U2.46 (GND), U2.47 (GND), U2.48 (GND), U2.49 (GND), U2.50 (GND), U2.51 (GND), U2.52 (GND), U2.53 (GND), U3.6, U14.3 (AGND), U14.5 (PGND), U14.8 (PG), U15.8 (GND), U15.11 (EP), U16.2, USB1.1 (GND), USB1.12 (GND), USB1.13 (SHELL), USB1.14 (SHELL); also elsewhere on the board
INT: U2.6 (IO3); also elsewhere on the board
MISO: U2.5 (IO2); also elsewhere on the board
MOSI: U2.15 (IO6); also elsewhere on the board
unnamed: F1.2, U16.1
unnamed: LED1.3 (+), RL1.1
unnamed: LED2.2 (A), RL2.2
unnamed: P1.6 (PROG), RA1.1
unnamed: Rb1.2, Rb2.2
unnamed: C234.1, U14.2 (FB)
unnamed: L1.1, U14.6 (SW)
unnamed: Rb5.1, U15.3 (CFG1)
unnamed: Rb4.1, U15.4 (CFG2)
unnamed: Rb3.2, U15.5 (CFG3)
unnamed: L2.1, U15.9 (LX1)
unnamed: L2.2, U15.7 (LX2)
unnamed: Rb6.2, Rb7.1, U15.2 (SEL)
unnamed: RD1.2, USB1.4 (CC1)
unnamed: RD2.2, USB1.10 (CC2)
PWDN: RPWDN1.2, U2.22 (IO8); also elsewhere on the board
R: LED1.1 (-), P1.1 (CHRG)
RESET: U2.16 (IO7); also elsewhere on the board
SCLK: U2.19 (IO14); also elsewhere on the board
START: U2.12 (IO0); also elsewhere on the board
USB_5V: D11.2 (A), F2.2, P1.4 (VCC), Q1.1 (G), R8.2, RL1.2
USB_5V_IN: F2.1, USB1.2 (VBUS), USB1.11 (VBUS)
VIN: C227.2, C232.1, R_adc2.2, Rb7.2, U3.5, U14.1 (EN), U14.7 (VIN), U15.1 (EN), U15.10 (VIN)
VSYS: D11.1 (C), Q1.2 (S), U3.4

Notes on the sheet:
5V Buck-Boost converter --- TO ADCs
You will see pure battery voltage or charging voltage if usb 5V are present
Charging current is 400 mA. 500 mA is max for this chip
ESP32 C6 MINI
Transistor can handle 460 mA, average pow. cons. of the board is 0.4W, so should be more than fine
LiPo charger / LED status
Vout = (R1/R2+1)*0.6
Switch is the entry point for the board system voltage. You can charge board, but it will not work until switch is on.
When 5V from USB are present 5V becomes system voltage and it also tries to charge Lipo if it's not charged yet.
USB-C + FUSE
For this dcdc 1% resistance accuracy is enought since it works by measuring discrete resistances
3V3↔3V3_MCU current sense (jumper U1 pin2–pin1)
Battery Connector + FUSE
3.3V Buck converter --- TO ESP AND ADCs digital part
ESP status LED
because of stupid resistors with 0.1% accuracy the only set i was able to find with some stock available is this >__<
to switch --->
System Voltage Sens
Switch (system voltage)
to ADCs --->
Host PMOD (2x6)
Charging status
Cap is needed to help to smooth out voltage noise
Power Path
TARGET is 3.236V

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
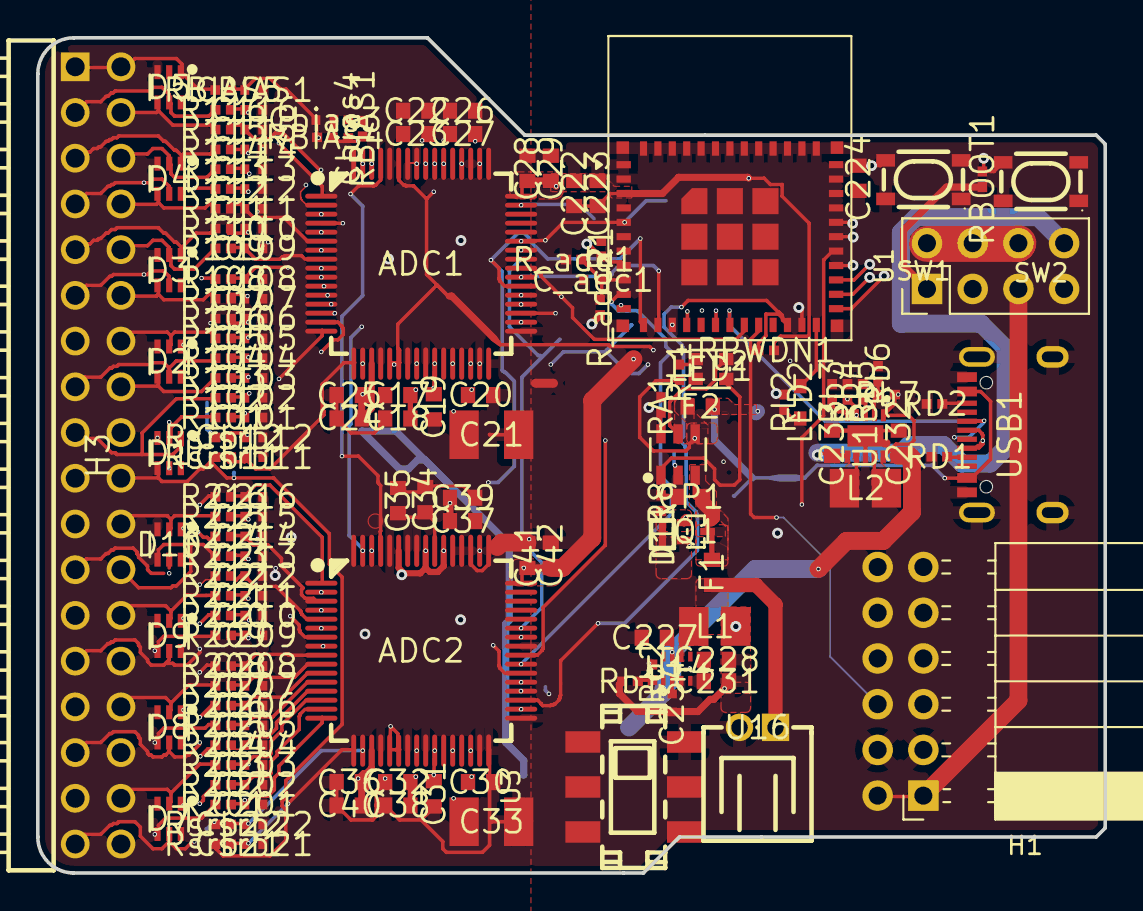
[picture p5: board import2.kicad_pcb from above]

Board: 4 copper layers, 59.3 x 46.4 mm, 165 parts (0 on the bottom side), 139 nets.
