HaydenKeers/meower_kicad/(commit log)

2026-08-06 Import with C6, pwr headers, PMOD. Many ERC
    [2_ADCs.kicad_sch, 3_ADC pins and connector.kicad_sch, 7_ESP and Power.kicad_sch, import2.kicad_pcb, import2.kicad_sch]
2026-08-06 Fix import2 ERC: pin types, references, and NC pins
    - Convert EasyEDA R/C input pins to passive in lib_symbols and symbol library
    - Set targeted pin types for ESP32-C6, TYPE-C, ADS1299 NC, TPD4E1B06, TPS62821
    - Annotate Short-Symbol jumpers (JP1-6), sheet frames (F1-F2), and #PWR flags
    - ERC: 576 violations / 122 errors -> 448 violations / 4 errors
    - Net names unchanged; remaining errors are BIASIN/BIASOUT wiring and GND PWR_FLAG
    [2_ADCs.kicad_sch, 3_ADC pins and connector.kicad_sch, 7_ESP and Power.kicad_sch]
2026-08-21 Fix ERC
    [2_ADCs.kicad_sch, 3_ADC pins and connector.kicad_sch, 7_ESP and Power.kicad_sch]
2026-08-21 Add boot and reset buttonss
    [7_ESP and Power.kicad_sch, import2.kicad_pcb]
2026-08-21 PCB update. DRC <300
    [2_ADCs.kicad_sch, 7_ESP and Power.kicad_sch, import2.kicad_pcb]
2026-08-23 Add buttons. Rework PSU placement. No missed connections. 220 errors
    [2_ADCs.kicad_sch, 3_ADC pins and connector.kicad_sch, 7_ESP and Power.kicad_sch, import2.kicad_pcb, import2.kicad_sch]
2026-08-23 No errors. Only silk warnings
    [import2.kicad_pcb]
